muhammadrizqonkz/ESC4IN1/PCBDesign/ESC4Layer.png

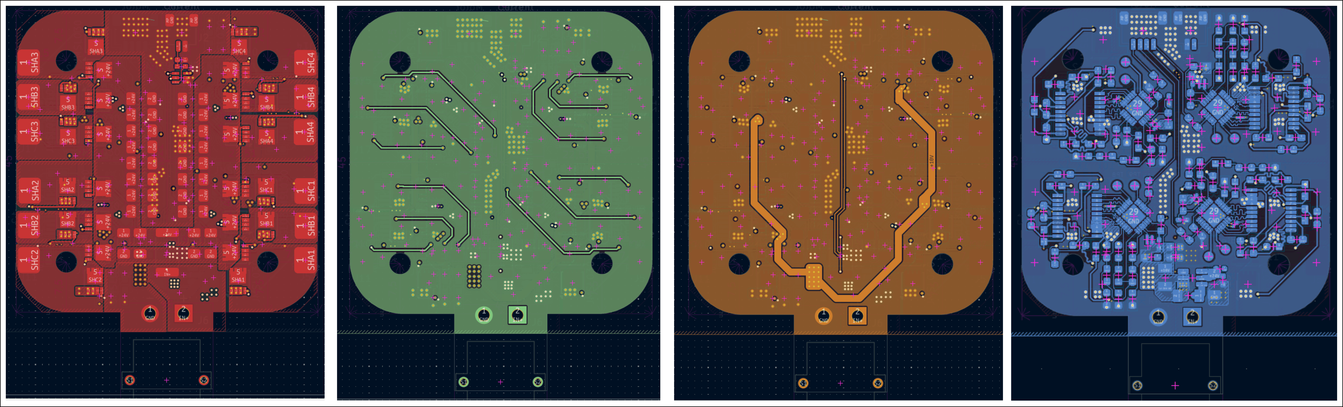
PCBDesign/ESC4Layer.png
