muhammadrizqonkz/ESC4IN1/MotorTest/ResistanceMeasure.jpeg

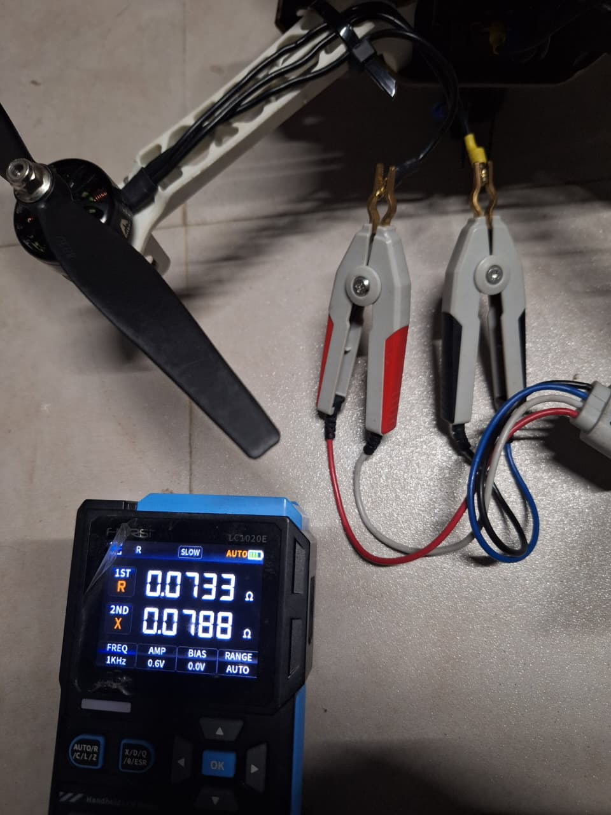
MotorTest/ResistanceMeasure.jpeg
