muhammadrizqonkz/ESC4IN1/README.md

# ESC4IN1

Dokumentasi proyek capstone ESC 4-in-1: desain PCB, simulasi, dan pengujian motor.

## Isi repositori

| Folder | Isi |
| --- | --- |
| [PCBDesign](PCBDesign/) | Desain PCB KiCad dan model 3D |
| [Simulation](Simulation/) | Model dan hasil simulasi |
| [MotorTest](MotorTest/) | Foto pengukuran dan pengujian |

## PCBDesign

- [Skematik](PCBDesign/ESC_4in1.kicad_sch)
- [Layout PCB](PCBDesign/ESC_4in1.kicad_pcb)
- [Project KiCad](PCBDesign/ESC_4in1.kicad_pro)
- [Model 3D (STEP)](PCBDesign/ESC.step)
- [Render 3D](PCBDesign/ESC3D.png)

## Simulation

- [Model simulasi](Simulation/ModelSimulasi.png)
- [Hasil simulasi](Simulation/HasilSimulasi.jpeg)

## MotorTest

- [Pengukuran induktansi](MotorTest/InductanceMeasure.jpeg)
- [Pengukuran resistansi](MotorTest/ResistanceMeasure.jpeg)
- [Kamera termal ESC](MotorTest/ThermalCamESC.jpeg)
