muhammadrizqonkz/ESC4IN1/Simulation/HasilSimulasi.jpeg

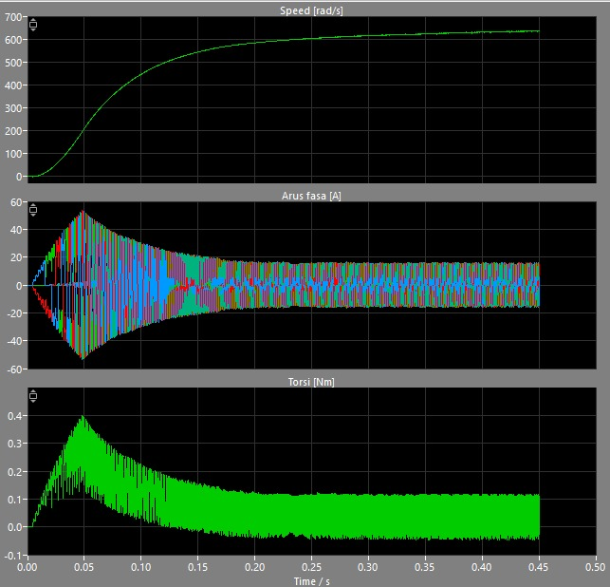
Simulation/HasilSimulasi.jpeg
