muhammadrizqonkz/ESC4IN1/Simulation/ModelSimulasi.png

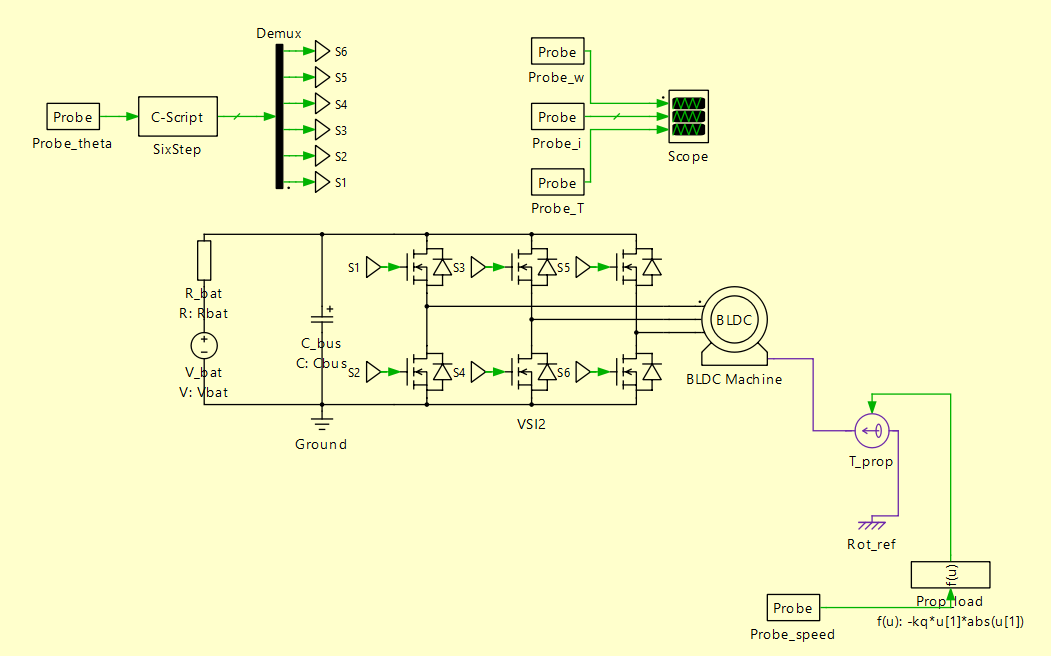
Simulation/ModelSimulasi.png
