muhammadrizqonkz/ESC4IN1/PCBDesign/ESC.step

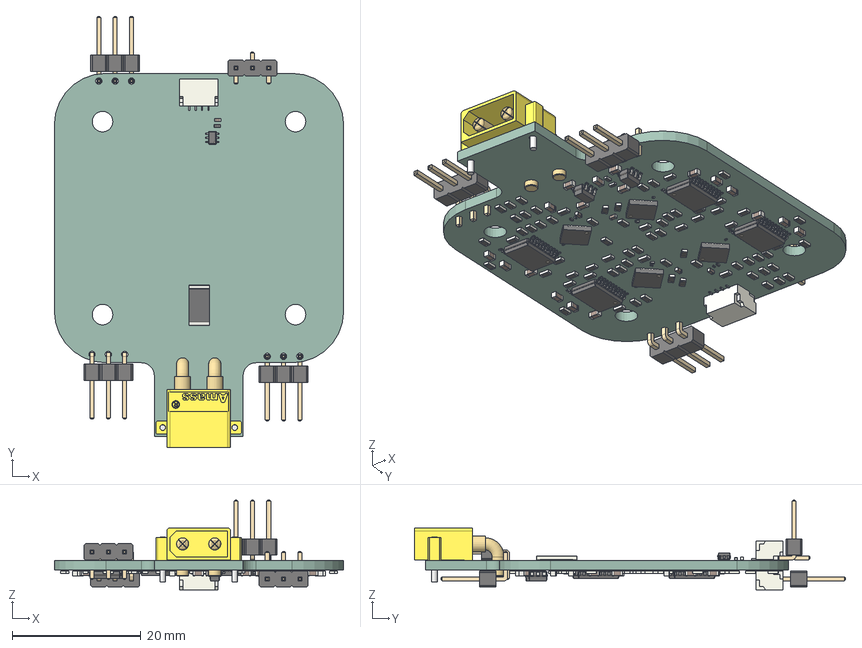
[picture p6: CAD file, 2026-11-09]
PCBDesign/ESC.step
45.0 x 67.0 x 13.9 mm
SOT-363_SC-70-6
C_0402_1005Metric x 5
Amass_XT30PW-M_pcb solder
R_0402_1005Metric x 3
PinHeader_1x03_P2.54mm_Horizontal x 3
JST_SH_SM04B-SRSS-TB_1x04-1MP_P1.00mm_Horizontal x 2
R_2512_6332Metric
PinHeader_1x03_P2.54mm_Vertical_SMD_Pin1Left
QFN-28-1EP_4x4mm_P0.4mm_EP2.4x2.4mm x 4
C_0603_1608Metric x 19
R_0603_1608Metric x 72
C_01005_0402Metric x 8
R_0201_0603Metric x 4
TSSOP-20_4.4x6.5mm_P0.65mm x 4
SOT-23-5
SOT-23-6
ESC_4in1_PCB
