muhammadrizqonkz/ESC4IN1/PCBDesign/ESC_4in1.kicad_pcb

## KiCad design PCBDesign/ESC_4in1.kicad_pcb (2026-11-09)

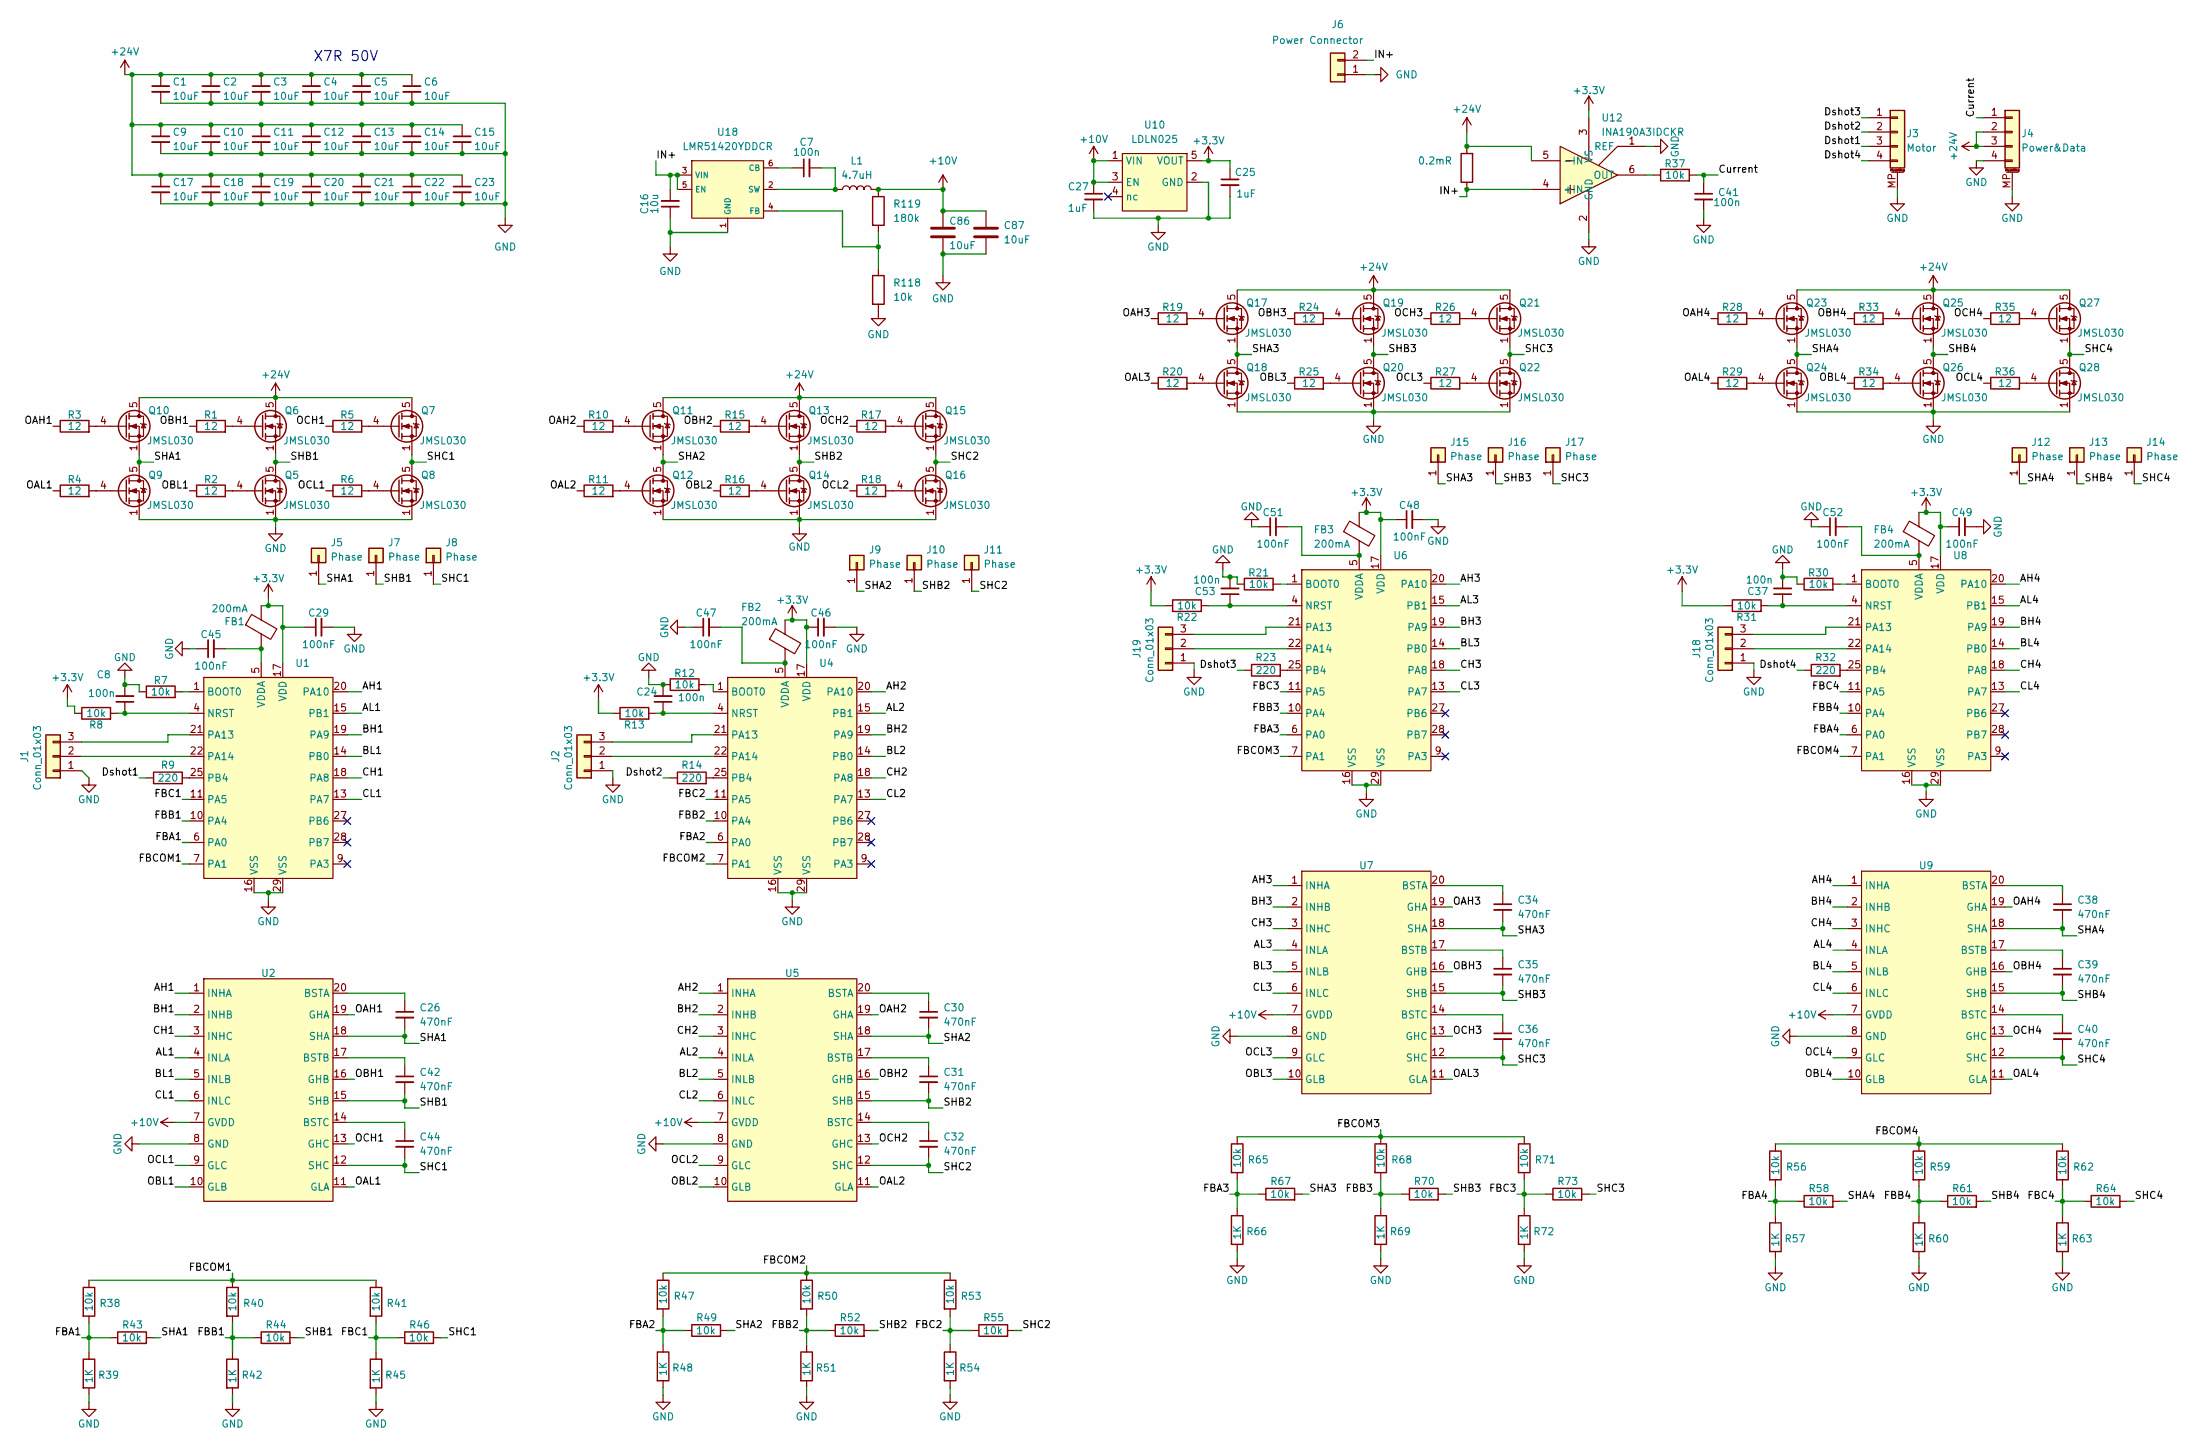
[picture p7: schematic ESC_4in1.kicad_sch]

Parts:
C1, C2, C3, C4, C5, C6, C9, C10, C11, C12, C13, C14, C15, C17, C18, C19, C20, C21, C22, C23: 10uF; C_1206_3216Metric_Pad1.33x1.80mm_HandSolder
C7: 100n; C_0603_1608Metric_Pad1.08x0.95mm_HandSolder
C8, C24, C37, C41, C53: 100n; C_0402_1005Metric_Pad0.74x0.62mm_HandSolder
C16: 10u; C_0603_1608Metric_Pad1.08x0.95mm_HandSolder
C25, C27: 1uF; C_0603_1608Metric_Pad1.08x0.95mm_HandSolder
C26, C30, C31, C32, C34, C35, C36, C38, C39, C40, C42, C44: 470nF; C_0603_1608Metric_Pad1.08x0.95mm_HandSolder
C29, C45, C46, C47, C48, C49, C51, C52: 100nF; C_01005_0402Metric_Pad0.57x0.30mm_HandSolder
C86, C87: 10uF; C_0603_1608Metric; LCSC C2762594
FB1, FB2, FB3, FB4: 200mA; R_0201_0603Metric_Pad0.64x0.40mm_HandSolder
J1, J2, J19: Conn_01x03; PinHeader_1x03_P2.54mm_Horizontal
J3: Motor; JST_SH_SM04B-SRSS-TB_1x04-1MP_P1.00mm_Horizontal
J4: Power&Data; JST_SH_SM04B-SRSS-TB_1x04-1MP_P1.00mm_Horizontal
J5, J7, J8, J9, J10, J11, J12, J13, J14, J15, J16, J17: Phase; motorterminal
J6: Power Connector; AMASS_XT30PW-M
J18: Conn_01x03; PinHeader_1x03_P2.54mm_Vertical_SMD_Pin1Left
L1: 4.7uH; SPM3012
Q5, Q6, Q7, Q8, Q9, Q10, Q11, Q12, Q13, Q14, Q15, Q16, Q17, Q18, Q19, Q20, Q21, Q22, Q23, Q24, Q25, Q26, Q27, Q28: JMSL030; Vishay_PowerPAK_1212-8_Single
R1, R2, R3, R4, R5, R6, R10, R11, R15, R16, R17, R18, R19, R20, R24, R25, R26, R27, R28, R29, R33, R34, R35, R36: 12; R_0603_1608Metric_Pad0.98x0.95mm_HandSolder
R7, R8, R12, R13, R21, R22, R30, R31, R38, R40, R41, R43, R44, R46, R47, R49, R50, R52, R53, R55, R56, R58, R59, R61, R62, R64, R65, R67, R68, R70, R71, R73: 10k; R_0603_1608Metric_Pad0.98x0.95mm_HandSolder
R9, R14, R23, R32: 220; R_0603_1608Metric_Pad0.98x0.95mm_HandSolder
R37: 10k; R_0402_1005Metric_Pad0.72x0.64mm_HandSolder
R39, R42, R45, R48, R51, R54, R57, R60, R63, R66, R69, R72: 1K; R_0603_1608Metric_Pad0.98x0.95mm_HandSolder
R118: 10k; R_0402_1005Metric_Pad0.72x0.64mm_HandSolder; LCSC C106225
R119: 180k; R_0402_1005Metric_Pad0.72x0.64mm_HandSolder; LCSC C423759
Rsense1: 0.2mR; R_2512_6332Metric; LCSC C695806
U1, U4, U6, U8: QFN-28-1EP_4x4mm_P0.4mm_EP2.4x2.4mm
U2, U5, U7, U9: TSSOP-20_4.4x6.5mm_P0.65mm
U10: LDLN025; SOT-23-5_HandSoldering
U12: INA190A3IDCKR; SOT-363_SC-70-6; LCSC C2058245
U18: LMR51420YDDCR; SOT-23-6_Handsoldering; LCSC C7296200

Connections:
+3.3V: C25.1, C29.1, C46.1, C48.1, C49.1, FB1.1, FB2.1, FB3.1, FB4.1, R8.1, R13.1, R22.1, R31.1, U1.17 (VDD), U4.17 (VDD), U6.17 (VDD), U8.17 (VDD), U10.5 (VOUT), U12.3 (VS)
+10V: C27.1, C86.1, C87.1, L1.1, R119.1, U2.7 (GVDD), U5.7 (GVDD), U7.7 (GVDD), U9.7 (GVDD), U10.1 (VIN), U10.3 (EN)
+24V: C1.1, C2.1, C3.1, C4.1, C5.1, C6.1, C9.1, C10.1, C11.1, C12.1, C13.1, C14.1, C15.1, C17.1, C18.1, C19.1, C20.1, C21.1, C22.1, C23.1, J4.2, J4.3, Q6.5 (D), Q7.5 (D), Q10.5 (D), Q11.5 (D), Q13.5 (D), Q15.5 (D), Q17.5 (D), Q19.5 (D), Q21.5 (D), Q23.5 (D), Q25.5 (D), Q27.5 (D), Rsense1.2, U12.5 (-IN)
/AH1: U1.20 (PA10), U2.1 (INHA)
/AH2: U4.20 (PA10), U5.1 (INHA)
/AH3: U6.20 (PA10), U7.1 (INHA)
/AH4: U8.20 (PA10), U9.1 (INHA)
/AL1: U1.15 (PB1), U2.4 (INLA)
/AL2: U4.15 (PB1), U5.4 (INLA)
/AL3: U6.15 (PB1), U7.4 (INLA)
/AL4: U8.15 (PB1), U9.4 (INLA)
/BH1: U1.19 (PA9), U2.2 (INHB)
/BH2: U4.19 (PA9), U5.2 (INHB)
/BH3: U6.19 (PA9), U7.2 (INHB)
/BH4: U8.19 (PA9), U9.2 (INHB)
/BL1: U1.14 (PB0), U2.5 (INLB)
/BL2: U4.14 (PB0), U5.5 (INLB)
/BL3: U6.14 (PB0), U7.5 (INLB)
/BL4: U8.14 (PB0), U9.5 (INLB)
/CH1: U1.18 (PA8), U2.3 (INHC)
/CH2: U4.18 (PA8), U5.3 (INHC)
/CH3: U6.18 (PA8), U7.3 (INHC)
/CH4: U8.18 (PA8), U9.3 (INHC)
/CL1: U1.13 (PA7), U2.6 (INLC)
/CL2: U4.13 (PA7), U5.6 (INLC)
/CL3: U6.13 (PA7), U7.6 (INLC)
/CL4: U8.13 (PA7), U9.6 (INLC)
/Current: C41.1, J4.1, R37.2
/Dshot1: J3.3, R9.1
/Dshot2: J3.2, R14.1
/Dshot3: J3.1, R23.1
/Dshot4: J3.4, R32.1
/FBA1: R38.2, R39.1, R43.1, U1.6 (PA0)
/FBA2: R47.2, R48.1, R49.1, U4.6 (PA0)
/FBA3: R65.2, R66.1, R67.1, U6.6 (PA0)
/FBA4: R56.2, R57.1, R58.1, U8.6 (PA0)
/FBB1: R40.2, R42.1, R44.1, U1.10 (PA4)
/FBB2: R50.2, R51.1, R52.1, U4.10 (PA4)
/FBB3: R68.2, R69.1, R70.1, U6.10 (PA4)
/FBB4: R59.2, R60.1, R61.1, U8.10 (PA4)
/FBC1: R41.2, R45.1, R46.1, U1.11 (PA5)
/FBC2: R53.2, R54.1, R55.1, U4.11 (PA5)
/FBC3: R71.2, R72.1, R73.1, U6.11 (PA5)
/FBC4: R62.2, R63.1, R64.1, U8.11 (PA5)
/FBCOM1: R38.1, R40.1, R41.1, U1.7 (PA1)
/FBCOM2: R47.1, R50.1, R53.1, U4.7 (PA1)
/FBCOM3: R65.1, R68.1, R71.1, U6.7 (PA1)
/FBCOM4: R56.1, R59.1, R62.1, U8.7 (PA1)
/IN+: C16.2, J6.2, Rsense1.1, U12.4 (+IN), U18.3 (VIN), U18.5 (EN)
/OAH1: R3.1, U2.19 (GHA)
/OAH2: R10.1, U5.19 (GHA)
/OAH3: R19.1, U7.19 (GHA)
/OAH4: R28.1, U9.19 (GHA)
/OAL1: R4.1, U2.11 (GLA)
/OAL2: R11.1, U5.11 (GLA)
/OAL3: R20.1, U7.11 (GLA)
/OAL4: R29.1, U9.11 (GLA)
/OBH1: R1.1, U2.16 (GHB)
/OBH2: R15.1, U5.16 (GHB)
/OBH3: R24.1, U7.16 (GHB)
/OBH4: R33.1, U9.16 (GHB)
/OBL1: R2.1, U2.10 (GLB)
/OBL2: R16.1, U5.10 (GLB)
/OBL3: R25.1, U7.10 (GLB)
/OBL4: R34.1, U9.10 (GLB)
/OCH1: R5.1, U2.13 (GHC)
/OCH2: R17.1, U5.13 (GHC)
/OCH3: R26.1, U7.13 (GHC)
/OCH4: R35.1, U9.13 (GHC)
/OCL1: R6.1, U2.9 (GLC)
/OCL2: R18.1, U5.9 (GLC)
/OCL3: R27.1, U7.9 (GLC)
/OCL4: R36.1, U9.9 (GLC)
/SHA1: C26.2, J5.1 (Pin_1_1), Q9.5 (D), Q10.1 (S), Q10.2 (S), Q10.3 (S), R43.2, U2.18 (SHA)
/SHA2: C30.2, J9.1 (Pin_1_1), Q11.1 (S), Q11.2 (S), Q11.3 (S), Q12.5 (D), R49.2, U5.18 (SHA)
/SHA3: C34.2, J15.1 (Pin_1_1), Q17.1 (S), Q17.2 (S), Q17.3 (S), Q18.5 (D), R67.2, U7.18 (SHA)
/SHA4: C38.2, J12.1 (Pin_1_1), Q23.1 (S), Q23.2 (S), Q23.3 (S), Q24.5 (D), R58.2, U9.18 (SHA); also elsewhere on the board
/SHB1: C42.2, J7.1 (Pin_1_1), Q5.5 (D), Q6.1 (S), Q6.2 (S), Q6.3 (S), R44.2, U2.15 (SHB)
/SHB2: C31.2, J10.1 (Pin_1_1), Q13.1 (S), Q13.2 (S), Q13.3 (S), Q14.5 (D), R52.2, U5.15 (SHB)
/SHB3: C35.2, J16.1 (Pin_1_1), Q19.1 (S), Q19.2 (S), Q19.3 (S), Q20.5 (D), R70.2, U7.15 (SHB)
/SHB4: C39.2, J13.1 (Pin_1_1), Q25.1 (S), Q25.2 (S), Q25.3 (S), Q26.5 (D), R61.2, U9.15 (SHB)
/SHC1: C44.2, J8.1 (Pin_1_1), Q7.1 (S), Q7.2 (S), Q7.3 (S), Q8.5 (D), R46.2, U2.12 (SHC)
/SHC2: C32.2, J11.1 (Pin_1_1), Q15.1 (S), Q15.2 (S), Q15.3 (S), Q16.5 (D), R55.2, U5.12 (SHC)
/SHC3: C36.2, J17.1 (Pin_1_1), Q21.1 (S), Q21.2 (S), Q21.3 (S), Q22.5 (D), R73.2, U7.12 (SHC)
/SHC4: C40.2, J14.1 (Pin_1_1), Q27.1 (S), Q27.2 (S), Q27.3 (S), Q28.5 (D), R64.2, U9.12 (SHC)
GND: C1.2, C2.2, C3.2, C4.2, C5.2, C6.2, C8.2, C9.2, C10.2, C11.2, C12.2, C13.2, C14.2, C15.2, C16.1, C17.2, C18.2, C19.2, C20.2, C21.2, C22.2, C23.2, C24.2, C25.2, C27.2, C29.2, C37.2, C41.2, C45.1, C46.2, C47.1, C48.2, C49.2, C51.1, C52.1, C53.2, C86.2, C87.2, J1.1, J2.1, J3.MP (MountPin), J4.4, J4.MP (MountPin), J6.1, J18.1, J19.1, Q5.1 (S), Q5.2 (S), Q5.3 (S), Q8.1 (S), Q8.2 (S), Q8.3 (S), Q9.1 (S), Q9.2 (S), Q9.3 (S), Q12.1 (S), Q12.2 (S), Q12.3 (S), Q14.1 (S), Q14.2 (S), Q14.3 (S), Q16.1 (S), Q16.2 (S), Q16.3 (S), Q18.1 (S), Q18.2 (S), Q18.3 (S), Q20.1 (S), Q20.2 (S), Q20.3 (S), Q22.1 (S), Q22.2 (S), Q22.3 (S), Q24.1 (S), Q24.2 (S), Q24.3 (S), Q26.1 (S), Q26.2 (S), Q26.3 (S), Q28.1 (S), Q28.2 (S), Q28.3 (S), R7.1, R12.1, R21.1, R30.1, R39.2, R42.2, R45.2, R48.2, R51.2, R54.2, R57.2, R60.2, R63.2, R66.2, R69.2, R72.2, R118.2, U1.16 (VSS), U1.29 (VSS), U2.8 (GND), U4.16 (VSS), U4.29 (VSS), U5.8 (GND), U6.16 (VSS), U6.29 (VSS), U7.8 (GND), U8.16 (VSS), U8.29 (VSS), U9.8 (GND), U10.2 (GND), U12.1 (REF), U12.2 (GND), U18.1 (GND)
unnamed: J1.2, U1.22 (PA14)
unnamed: J1.3, U1.21 (PA13)
unnamed: J2.2, U4.22 (PA14)
unnamed: J2.3, U4.21 (PA13)
unnamed: J18.2, U8.22 (PA14)
unnamed: J18.3, U8.21 (PA13)
unnamed: J19.2, U6.22 (PA14)
unnamed: J19.3, U6.21 (PA13)
unnamed: Q5.4 (G), R2.2
unnamed: Q6.4 (G), R1.2
unnamed: Q7.4 (G), R5.2
unnamed: Q8.4 (G), R6.2
unnamed: Q9.4 (G), R4.2
unnamed: Q10.4 (G), R3.2
unnamed: Q11.4 (G), R10.2
unnamed: Q12.4 (G), R11.2
unnamed: Q13.4 (G), R15.2
unnamed: Q14.4 (G), R16.2
unnamed: Q15.4 (G), R17.2
unnamed: Q16.4 (G), R18.2
unnamed: Q17.4 (G), R19.2
unnamed: Q18.4 (G), R20.2
unnamed: Q19.4 (G), R24.2
unnamed: Q20.4 (G), R25.2
unnamed: Q21.4 (G), R26.2
unnamed: Q22.4 (G), R27.2
unnamed: Q23.4 (G), R28.2
unnamed: Q24.4 (G), R29.2
unnamed: Q25.4 (G), R33.2
unnamed: Q26.4 (G), R34.2
unnamed: Q27.4 (G), R35.2
unnamed: Q28.4 (G), R36.2
unnamed: R7.2, U1.1 (BOOT0)
unnamed: C8.1, R8.2, U1.4 (NRST)
unnamed: R9.2, U1.25 (PB4)
unnamed: C45.2, FB1.2, U1.5 (VDDA)
unnamed: C26.1, U2.20 (BSTA)
unnamed: C42.1, U2.17 (BSTB)
unnamed: C44.1, U2.14 (BSTC)
unnamed: R12.2, U4.1 (BOOT0)
unnamed: C24.1, R13.2, U4.4 (NRST)
unnamed: R14.2, U4.25 (PB4)
unnamed: C47.2, FB2.2, U4.5 (VDDA)
unnamed: C30.1, U5.20 (BSTA)
unnamed: C31.1, U5.17 (BSTB)
unnamed: C32.1, U5.14 (BSTC)
unnamed: R21.2, U6.1 (BOOT0)
unnamed: C53.1, R22.2, U6.4 (NRST)
unnamed: R23.2, U6.25 (PB4)
unnamed: C51.2, FB3.2, U6.5 (VDDA)
unnamed: C34.1, U7.20 (BSTA)
unnamed: C35.1, U7.17 (BSTB)
unnamed: C36.1, U7.14 (BSTC)
unnamed: R30.2, U8.1 (BOOT0)
unnamed: C37.1, R31.2, U8.4 (NRST)
unnamed: R32.2, U8.25 (PB4)
unnamed: C52.2, FB4.2, U8.5 (VDDA)
unnamed 143: C38.1, U9.20 (BSTA); also elsewhere on the board
unnamed: C39.1, U9.17 (BSTB)
unnamed: C40.1, U9.14 (BSTC)
unnamed: R37.1, U12.6 (OUT)
unnamed: C7.1, U18.6 (CB)
unnamed: R118.1, R119.2, U18.4 (FB)
unnamed: C7.2, L1.2, U18.2 (SW)

Notes on the sheet:
X7R 50V

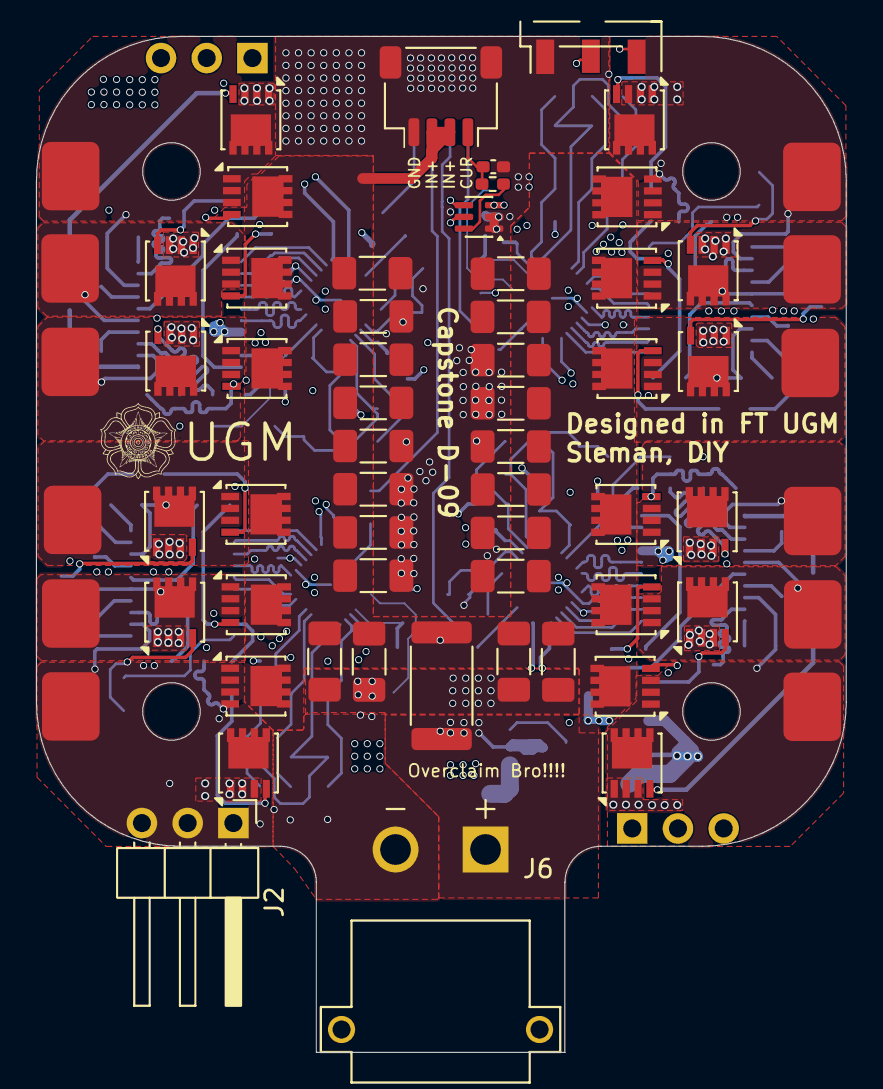
[picture p8: board ESC_4in1.kicad_pcb from above]

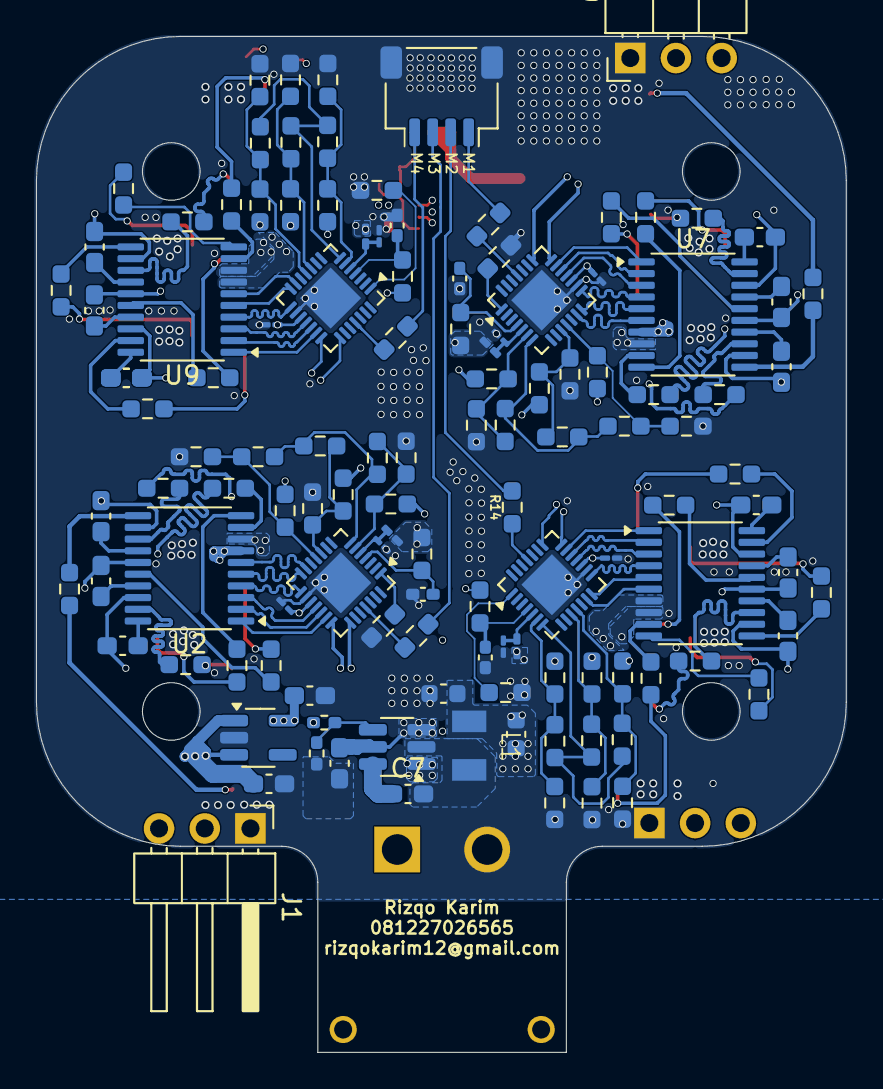
[picture p9: board ESC_4in1.kicad_pcb from below]

Board: 4 copper layers, 45.0 x 56.4 mm, 187 parts (123 on the bottom side), 150 nets.

Other parts of the board:
C30#2: 470nF; C_0603_1608Metric_Pad1.08x0.95mm_HandSolder

Their connections:
/SHA4: C30#2.2; also elsewhere on the board
unnamed 143: C30#2.1; also elsewhere on the board
