muhammadrizqonkz/ESC4IN1/MotorTest/InductanceMeasure.jpeg

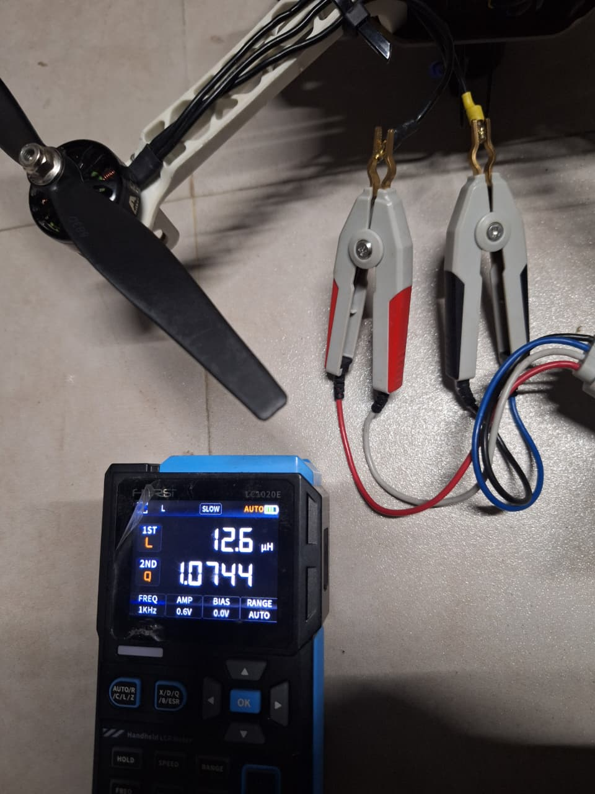
MotorTest/InductanceMeasure.jpeg
