muhammadrizqonkz/ESC4IN1/MotorTest/ThermalCamESC.jpeg

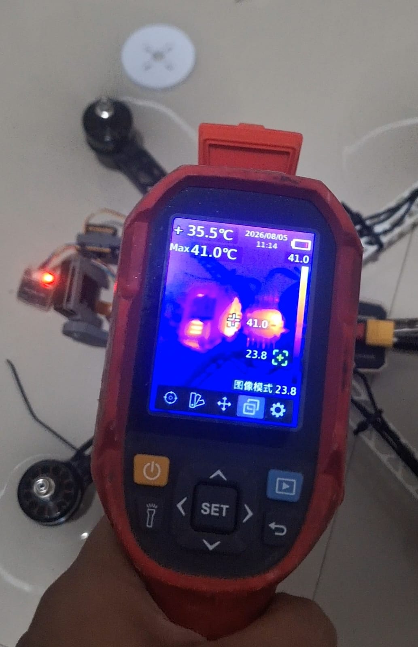
MotorTest/ThermalCamESC.jpeg
