muhammadrizqonkz/ESC4IN1/PCBDesign/ESC3D.png

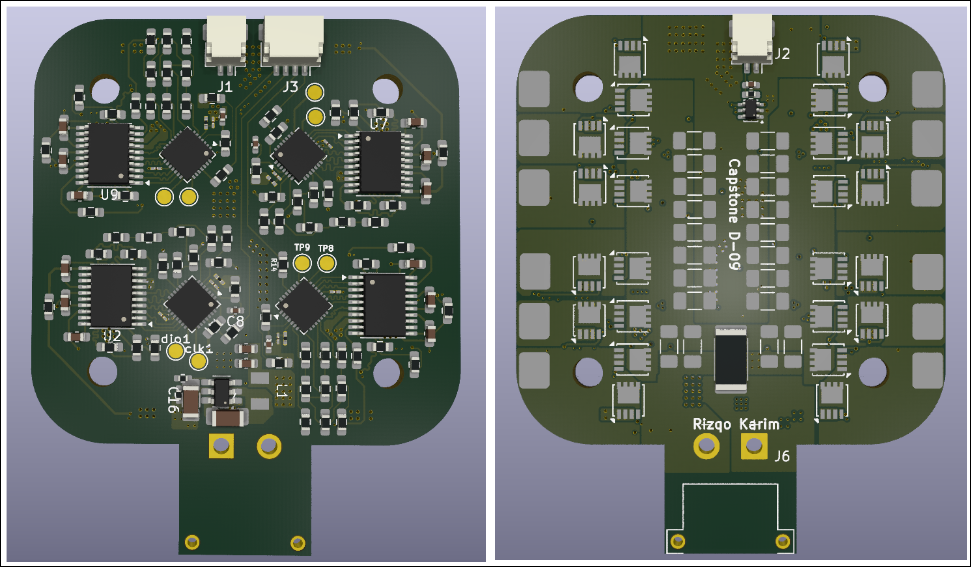
PCBDesign/ESC3D.png
